orpheus016/Programmable-Instrumentation-Amplifier-IP/xschem/ota_cmos5l/README.md

# OTA Specs and Performance

## Topology


## Physical Spec
```ngspice
.param lbias=0.15u wbias=0.15u
.param m6=1 m7=4 m8=8
.param linpair=3u winpair=20u
.param lload=5u wload=10u
.param lcs=3u wcs=20u
.param Cc=2p
```

## Metrics
- P = 29.57uW
- Gain ($A_{ol}$) = 57.21 dB
- Phase Margin (PM) = 64.88 deg
- $f_3{dB}$ or fc = 4.02kHz
- UGB ft = 2.78 MHz
- PSD noise at 1mHz = $189.56 nV/\sqrt{Hz}$
- Vos = 124.4 uV - 2.3 mV (worst case at 1.5 V outside ICMR)

## Plots





## Future Plan
- Defo add more gm on the input pair
- Automated characterization and reporting to this file for better viewing
- CACE?
- Move .param to core
- Automate physical metric log and the improtant ops
