orpheus016/Programmable-Instrumentation-Amplifier-IP/xschem/instramp_cmos5l/README.md

# OTA Specs and Performance

## Topology


## Physical Spec
```ngspice
.param lbias=0.15u wbias=0.15u
.param m6=1 m7=4 m8=8
.param linpair=3u winpair=20u
.param lload=5u wload=10u
.param lcs=3u wcs=20u
.param Cc=2p
```

## Metrics
- TBA

## Plots

TBA

## Future Plan

TBA
