orpheus016/Programmable-Instrumentation-Amplifier-IP/xschem/ota_cmos5l/tb/tb_ota_cmos5l_ac/Phase.png

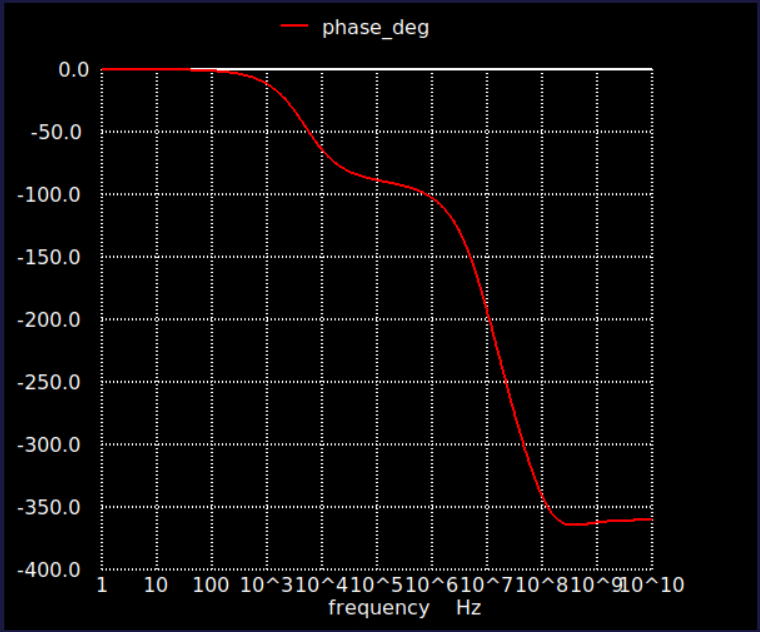
xschem/ota_cmos5l/tb/tb_ota_cmos5l_ac/Phase.png
