orpheus016/Programmable-Instrumentation-Amplifier-IP/xschem/coarse_gain/tb/tb_cg_ota/simulations/result/tb_cg_ota_mc.csv

-1.34387635e-02 -1.34387635e-02 -1.34387635e-02  7.38450235e+01
-2.05918607e-02 -2.05918607e-02 -2.05918607e-02  7.39088433e+01
-1.00258531e-02 -1.00258531e-02 -1.00258531e-02  7.38144310e+01
-1.93135983e-02 -1.93135983e-02 -1.93135983e-02  7.38974691e+01
-4.39906631e-03 -4.39906631e-03 -4.39906631e-03  7.37638051e+01
-1.29278388e-02 -1.29278388e-02 -1.29278388e-02  7.38404534e+01
-1.16658685e-02 -1.16658685e-02 -1.16658685e-02  7.38291441e+01
-1.15911407e-02 -1.15911407e-02 -1.15911407e-02  7.38284727e+01
-1.43986031e-02 -1.43986031e-02 -1.43986031e-02  7.38536136e+01
-1.26565231e-02 -1.26565231e-02 -1.26565231e-02  7.38380199e+01
-1.77818139e-02 -1.77818139e-02 -1.77818139e-02  7.38838240e+01
-7.46124374e-03 -7.46124374e-03 -7.46124374e-03  7.37913851e+01
-8.64012259e-03 -8.64012259e-03 -8.64012259e-03  7.38019851e+01
-5.71183264e-03 -5.71183264e-03 -5.71183264e-03  7.37756342e+01
-1.38807343e-02 -1.38807343e-02 -1.38807343e-02  7.38489808e+01
-7.11992922e-03 -7.11992922e-03 -7.11992922e-03  7.37883161e+01
-9.72987968e-03 -9.72987968e-03 -9.72987968e-03  7.38117768e+01
-8.88432773e-03 -8.88432773e-03 -8.88432773e-03  7.38041821e+01
-1.29114459e-02 -1.29114459e-02 -1.29114459e-02  7.38403068e+01
-1.26634110e-02 -1.26634110e-02 -1.26634110e-02  7.38380830e+01
-8.90168015e-03 -8.90168015e-03 -8.90168015e-03  7.38043364e+01
-7.39393628e-03 -7.39393628e-03 -7.39393628e-03  7.37907832e+01
-6.30688033e-03 -6.30688033e-03 -6.30688033e-03  7.37809958e+01
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
-2.00083376e-02 -2.00083376e-02 -2.00083376e-02  7.39036557e+01
-1.66586791e-02 -1.66586791e-02 -1.66586791e-02  7.38738045e+01
-1.30139339e-02 -1.30139339e-02 -1.30139339e-02  7.38412196e+01
-9.79154033e-03 -9.79154033e-03 -9.79154033e-03  7.38123270e+01
-1.49115925e-02 -1.49115925e-02 -1.49115925e-02  7.38581981e+01
-9.58710271e-03 -9.58710271e-03 -9.58710271e-03  7.38104955e+01
-1.02307613e-02 -1.02307613e-02 -1.02307613e-02  7.38162740e+01
-2.17640397e-02 -2.17640397e-02 -2.17640397e-02  7.39192677e+01
-7.36889456e-03 -7.36889456e-03 -7.36889456e-03  7.37905546e+01
-1.40237872e-02 -1.40237872e-02 -1.40237872e-02  7.38502614e+01
-1.79967887e-02 -1.79967887e-02 -1.79967887e-02  7.38857361e+01
-8.21061456e-03 -8.21061456e-03 -8.21061456e-03  7.37981236e+01
