orpheus016/Programmable-Instrumentation-Amplifier-IP/xschem/coarse_gain/tb/tb_cg_ota/simulations/result/tb_cg_ota_mc.png

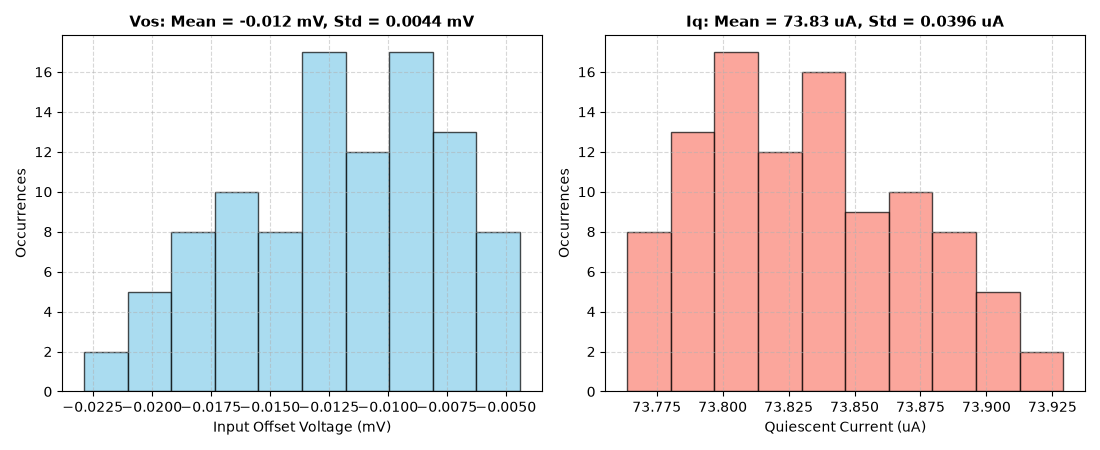
xschem/coarse_gain/tb/tb_cg_ota/simulations/result/tb_cg_ota_mc.png
