orpheus016/Programmable-Instrumentation-Amplifier-IP/xschem/coarse_gain/simulations/cg_network.spice

** sch_path: /foss/designs/sg13cmos5l_spma_ip__instramp/xschem/coarse_gain/cg_network.sch
**.subckt cg_network S4 S5 S0 S2 S1 S3 S14 S13 S12 S11 S10 S9 S8 S7 S6 S15 AVDD V_CM V_IN2 V_OUT2 I_BIAS AVSS
*.ipin I_BIAS
*.ipin V_IN2
*.ipin V_CM
*.ipin AVSS
*.ipin AVDD
*.opin V_OUT2
*.ipin S15
*.ipin S14
*.ipin S13
*.ipin S12
*.ipin S11
*.ipin S10
*.ipin S9
*.ipin S8
*.ipin S7
*.ipin S6
*.ipin S5
*.ipin S4
*.ipin S3
*.ipin S2
*.ipin S1
*.ipin S0
XR2 net12 net13 AVSS rhigh w=0.5e-6 l=9.6e-6 m=1 b=32 mm_ok=1
XR3 net13 net14 AVSS rhigh w=0.5e-6 l=4.5e-6 m=1 b=32 mm_ok=1
XR4 net14 net15 AVSS rhigh w=0.5e-6 l=5e-6 m=1 b=16 mm_ok=1
XR5 net15 net16 AVSS rhigh w=0.5e-6 l=5.5e-6 m=1 b=8 mm_ok=1
XR6 net16 net11 AVSS rhigh w=0.5e-6 l=4.7e-6 m=1 b=4 mm_ok=1
XR7 net11 net10 AVSS rhigh w=0.5e-6 l=5.41e-6 m=1 b=2 mm_ok=1
XR8 net10 net9 AVSS rhigh w=0.5e-6 l=3.34e-6 m=1 b=2 mm_ok=1
XR9 net9 net8 AVSS rhigh w=0.5e-6 l=7.39e-6 m=1 b=0 mm_ok=1
XR10 net8 net7 AVSS rhigh w=0.5e-6 l=4.76e-6 m=1 b=0 mm_ok=1
XR11 net7 net6 AVSS rhigh w=0.5e-6 l=3.06e-6 m=1 b=0 mm_ok=1
XR12 net6 net5 AVSS rhigh w=0.5e-6 l=1.94e-6 m=1 b=0 mm_ok=1
XR16 net2 net1 AVSS rppd w=2e-6 l=8.08e-6 m=1 b=0 mm_ok=1
XR17 net3 net2 AVSS rppd w=2e-6 l=5.1e-6 m=1 b=1 mm_ok=1
XR15 net1 V_OUT2 AVSS rppd w=2e-6 l=7.6e-6 m=1 b=0 mm_ok=1
XR18 net17 V_IN2 AVSS rppd w=0.5e-6 l=3.62e-6 m=1 b=0 mm_ok=1
XR1 net4 net3 AVSS rppd w=2e-6 l=8.65e-6 m=1 b=1 mm_ok=1
XR13 net5 net4 AVSS rppd w=2e-6 l=8.5e-6 m=1 b=2 mm_ok=1
x18 net18 S15 AVDD AVSS sg13cmos5l_inv_1
x19 net19 S14 AVDD AVSS sg13cmos5l_inv_1
x20 net20 S13 AVDD AVSS sg13cmos5l_inv_1
x21 net21 S12 AVDD AVSS sg13cmos5l_inv_1
x22 net22 S11 AVDD AVSS sg13cmos5l_inv_1
x23 net23 S10 AVDD AVSS sg13cmos5l_inv_1
x24 net24 S9 AVDD AVSS sg13cmos5l_inv_1
x25 net25 S8 AVDD AVSS sg13cmos5l_inv_1
x26 net26 S7 AVDD AVSS sg13cmos5l_inv_1
x27 net27 S6 AVDD AVSS sg13cmos5l_inv_1
x28 net28 S5 AVDD AVSS sg13cmos5l_inv_1
x29 net29 S4 AVDD AVSS sg13cmos5l_inv_1
x30 net30 S3 AVDD AVSS sg13cmos5l_inv_1
x31 net31 S2 AVDD AVSS sg13cmos5l_inv_1
x32 net32 S1 AVDD AVSS sg13cmos5l_inv_1
x33 net33 S0 AVDD AVSS sg13cmos5l_inv_1
x2 net17 AVSS AVDD S15 net18 net12 tgate l=0.13e-6 wn=0.15e-6 wp=0.45e-6
x3 net17 AVSS AVDD S14 net19 net13 tgate l=0.13e-6 wn=0.15e-6 wp=0.45e-6
x4 net17 AVSS AVDD S13 net20 net14 tgate l=0.13e-6 wn=0.15e-6 wp=0.45e-6
x5 net17 AVSS AVDD S12 net21 net15 tgate l=0.13e-6 wn=0.15e-6 wp=0.45e-6
x6 net17 AVSS AVDD S11 net22 net16 tgate l=0.13e-6 wn=0.15e-6 wp=0.45e-6
x7 net17 AVSS AVDD S10 net23 net11 tgate l=0.13e-6 wn=0.2e-6 wp=0.6e-6
x8 net17 AVSS AVDD S9 net24 net10 tgate l=0.13e-6 wn=0.5e-6 wp=1.5e-6
x9 net17 AVSS AVDD S8 net25 net9 tgate l=0.13e-6 wn=1e-6 wp=3e-6
x10 net17 AVSS AVDD S7 net26 net8 tgate l=0.13e-6 wn=1e-6 wp=3e-6
x11 net17 AVSS AVDD S6 net27 net7 tgate l=0.13e-6 wn=1.5e-6 wp=4.5e-6
x12 net17 AVSS AVDD S5 net28 net6 tgate l=0.13e-6 wn=2e-6 wp=6e-6
x13 net17 AVSS AVDD S4 net29 net5 tgate l=0.13e-6 wn=3e-6 wp=9e-6
x14 net17 AVSS AVDD S3 net30 net4 tgate l=0.13e-6 wn=3e-6 wp=9e-6
x15 net17 AVSS AVDD S2 net31 net3 tgate l=0.13e-6 wn=3e-6 wp=9e-6
x16 net17 AVSS AVDD S1 net32 net2 tgate l=0.13e-6 wn=3e-6 wp=9e-6
x17 net17 AVSS AVDD S0 net33 net1 tgate l=0.13e-6 wn=3e-6 wp=9e-6
x1 AVDD V_CM net17 V_OUT2 I_BIAS AVSS cg_ota
**.ends

* expanding   symbol:  /foss/designs/sg13cmos5l_spma_ip__instramp/xschem/tgate/tgate.sym # of pins=6
** sym_path: /foss/designs/sg13cmos5l_spma_ip__instramp/xschem/tgate/tgate.sym
** sch_path: /foss/designs/sg13cmos5l_spma_ip__instramp/xschem/tgate/tgate.sch
.subckt tgate IN AVSS AVDD EN ENB OUT  l=0.13e-6 wn=1e-6 wp=3e-6
*.iopin AVDD
*.iopin AVSS
*.iopin IN
*.iopin OUT
*.ipin EN
*.ipin ENB
XM1 IN EN OUT AVSS sg13_lv_nmos w=wn l=l ng=1 m=1 mm_ok=1
XM2 OUT ENB IN AVDD sg13_lv_pmos w=wp l=l ng=1 m=1 mm_ok=1
.ends


* expanding   symbol:  cg_ota.sym # of pins=6
** sym_path: /foss/designs/sg13cmos5l_spma_ip__instramp/xschem/coarse_gain/cg_ota.sym
** sch_path: /foss/designs/sg13cmos5l_spma_ip__instramp/xschem/coarse_gain/cg_ota.sch
.subckt cg_ota VDD V_inp V_inn V_out I_bias VSS
*.ipin V_inn
*.ipin VDD
*.ipin VSS
*.opin V_out
*.ipin I_bias
*.ipin V_inp
XM1 F1 V_inn net6 VDD sg13_lv_pmos w=26.56u l=2u ng=4 m=1 mm_ok=1
XM2 F2 V_inp net6 VDD sg13_lv_pmos w=26.56u l=2u ng=4 m=1 mm_ok=1
XM3 net5 net5 VDD VDD sg13_lv_pmos w=7.33u l=2u ng=1 m=1 mm_ok=1
XM4 N_A net5 VDD VDD sg13_lv_pmos w=7.33u l=2u ng=1 m=1 mm_ok=1
XM7 F1 V_bn2 VSS VSS sg13_lv_nmos w=9.21u l=2u ng=1 m=1 mm_ok=1
XM8 F2 V_bn2 VSS VSS sg13_lv_nmos w=9.21u l=2u ng=1 m=1 mm_ok=1
XM_tail net6 V_btail VDD VDD sg13_lv_pmos w=7.46u l=2u ng=1 m=8 mm_ok=1
XM_ctrlp N_B V_ctrlp N_A VDD sg13_lv_pmos w=2.20u l=0.50u ng=1 m=1 mm_ok=1
XM_outp V_out N_A VDD VDD sg13_lv_pmos w=22.20u l=0.5u ng=4 m=1 mm_ok=1
XM_ctrln N_A V_ctrln N_B VSS sg13_lv_nmos w=0.84u l=0.5u ng=1 m=1 mm_ok=1
XM_outn V_out N_B VSS VSS sg13_lv_nmos w=8.4u l=0.5u ng=1 m=1 mm_ok=1
XM5 net5 V_bn1 F1 VSS sg13_lv_nmos w=6.41u l=2u ng=1 m=1 mm_ok=1
XM6 N_A V_bn1 F2 VSS sg13_lv_nmos w=6.41u l=2u ng=1 m=1 mm_ok=1
XM_mp1 net1 net1 VDD VDD sg13_lv_pmos w=2.30u l=2u ng=1 m=1 mm_ok=1
XM_mn1 net1 I_bias VSS VSS sg13_lv_nmos w=0.87u l=2u ng=1 m=1 mm_ok=1
XM_refn I_bias I_bias VSS VSS sg13_lv_nmos w=0.87u l=2u ng=1 m=1 mm_ok=1
XM_mp2 V_bn1 net1 VDD VDD sg13_lv_pmos w=11.50u l=2u ng=2 m=1 mm_ok=1
XM_mp3 V_bn2 net1 VDD VDD sg13_lv_pmos w=23u l=2u ng=4 m=1 mm_ok=1
XM_bn1 V_bn1 V_bn1 net2 VSS sg13_lv_nmos w=1.60u l=2u ng=1 m=1 mm_ok=1
XM_bn2 V_bn2 V_bn2 VSS VSS sg13_lv_nmos w=9.21u l=2u ng=1 m=1 mm_ok=1
XM_mn2 V_btail I_bias VSS VSS sg13_lv_nmos w=6u l=2u ng=1 m=1 mm_ok=1
XM_rep_tail V_btail V_btail VDD VDD sg13_lv_pmos w=7.46u l=2u ng=1 m=8 mm_ok=1
XM_mn4 N_B I_bias VSS VSS sg13_lv_nmos w=3.2u l=2u ng=1 m=1 mm_ok=1
XC1 F2 V_out cap_cmomf w=22e-6 l=22e-6 mmin=1 mmax=4 subblock=0 m=1 mm_ok=1
XC2 net7 V_out cap_cmomf w=15.44e-6 l=15.44e-6 mmin=1 mmax=4 subblock=0 m=1 mm_ok=1
XR1 net2 VSS VSS rhigh w=0.5e-6 l=15e-6 m=1 b=0 mm_ok=1
XM_mp4 V_ctrln net1 VDD VDD sg13_lv_pmos w=4.60u l=2u ng=1 m=1 mm_ok=1
XM_rep_ctrln V_ctrln V_ctrln net3 VSS sg13_lv_nmos w=0.84u l=0.5u ng=1 m=1 mm_ok=1
XM_rep_outn net3 net3 VSS VSS sg13_lv_nmos w=2.10u l=0.5u ng=1 m=1 mm_ok=1
XM_mn3 V_ctrlp I_bias VSS VSS sg13_lv_nmos w=1.74u l=2u ng=1 m=1 mm_ok=1
XM_rep_outp net4 net4 VDD VDD sg13_lv_pmos w=5.55u l=0.5u ng=1 m=1 mm_ok=1
XM_rep_ctrlp V_ctrlp V_ctrlp net4 VDD sg13_lv_pmos w=2.20u l=0.50u ng=1 m=1 mm_ok=1
XM_mp5 N_A net1 VDD VDD sg13_lv_pmos w=9.21u l=2u ng=1 m=1 mm_ok=1
XR2 N_A net7 VSS rhigh w=0.5e-6 l=4e-6 m=1 b=0 mm_ok=1
.ends

.end
