orpheus016/Programmable-Instrumentation-Amplifier-IP/xschem/decoder_top_10b/librelane/final/spice/decoder_top_10b.spice

* NGSPICE file created from decoder_top_10b.ext - technology: ihp-sg13g2

* Black-box entry subcircuit for sg13g2_fill_1 abstract view
.subckt sg13g2_fill_1 VDD VSS
.ends

* Black-box entry subcircuit for sg13g2_decap_8 abstract view
.subckt sg13g2_decap_8 VDD VSS
.ends

* Black-box entry subcircuit for sg13g2_decap_4 abstract view
.subckt sg13g2_decap_4 VDD VSS
.ends

* Black-box entry subcircuit for sg13g2_fill_2 abstract view
.subckt sg13g2_fill_2 VDD VSS
.ends

* Black-box entry subcircuit for sg13g2_buf_1 abstract view
.subckt sg13g2_buf_1 X A VDD VSS
.ends

* Black-box entry subcircuit for sg13g2_nor3_1 abstract view
.subckt sg13g2_nor3_1 Y A B C VDD VSS
.ends

* Black-box entry subcircuit for sg13g2_nor4_1 abstract view
.subckt sg13g2_nor4_1 Y A B C D VDD VSS
.ends

* Black-box entry subcircuit for sg13g2_inv_1 abstract view
.subckt sg13g2_inv_1 Y A VDD VSS
.ends

* Black-box entry subcircuit for sg13g2_nor2_1 abstract view
.subckt sg13g2_nor2_1 Y A B VDD VSS
.ends

* Black-box entry subcircuit for sg13g2_nand3_1 abstract view
.subckt sg13g2_nand3_1 Y A B C VDD VSS
.ends

* Black-box entry subcircuit for sg13g2_nand2_1 abstract view
.subckt sg13g2_nand2_1 Y A B VDD VSS
.ends

* Black-box entry subcircuit for sg13g2_nand2b_1 abstract view
.subckt sg13g2_nand2b_1 Y A_N B VDD VSS
.ends

.subckt decoder_top_10b VGND VPWR d[0] d[1] d[2] d[3] d[4] d[5] d[6] d[7] d[8] d[9]
+ s[4] s[5] s[6] s[7] s[8] s[9] sb[4] sb[5] sb[6] sb[7] sb[8] sb[9] y[0] y[10] y[11]
+ y[12] y[13] y[14] y[15] y[1] y[2] y[3] y[4] y[5] y[6] y[7] y[8] y[9]
XFILLER_3_56 VPWR VGND sg13g2_fill_1
XFILLER_6_107 VPWR VGND sg13g2_decap_8
XFILLER_9_126 VPWR VGND sg13g2_decap_4
XFILLER_0_35 VPWR VGND sg13g2_decap_8
XFILLER_9_77 VPWR VGND sg13g2_decap_8
XFILLER_6_23 VPWR VGND sg13g2_decap_8
XFILLER_3_35 VPWR VGND sg13g2_decap_8
XFILLER_7_8 VPWR VGND sg13g2_fill_2
Xoutput31 y[2] _18_/Y VPWR VGND sg13g2_buf_1
Xoutput20 sb[7] _09_/Y VPWR VGND sg13g2_buf_1
XFILLER_9_105 VPWR VGND sg13g2_decap_8
XFILLER_0_14 VPWR VGND sg13g2_decap_8
XFILLER_9_34 VPWR VGND sg13g2_decap_8
XFILLER_6_79 VPWR VGND sg13g2_decap_8
Xoutput32 y[3] _20_/Y VPWR VGND sg13g2_buf_1
Xoutput21 sb[8] _10_/Y VPWR VGND sg13g2_buf_1
XFILLER_10_127 VPWR VGND sg13g2_decap_4
XFILLER_3_14 VPWR VGND sg13g2_decap_8
XFILLER_3_69 VPWR VGND sg13g2_decap_8
XFILLER_9_57 VPWR VGND sg13g2_fill_2
XFILLER_9_13 VPWR VGND sg13g2_decap_8
XFILLER_1_91 VPWR VGND sg13g2_decap_8
XFILLER_6_58 VPWR VGND sg13g2_decap_4
Xoutput33 y[4] _21_/Y VPWR VGND sg13g2_buf_1
Xoutput22 sb[9] _11_/Y VPWR VGND sg13g2_buf_1
Xoutput11 s[4] _34_/X VPWR VGND sg13g2_buf_1
XFILLER_10_106 VPWR VGND sg13g2_decap_8
XFILLER_0_49 VPWR VGND sg13g2_decap_4
XFILLER_2_113 VPWR VGND sg13g2_decap_8
XFILLER_1_70 VPWR VGND sg13g2_decap_8
XFILLER_6_37 VPWR VGND sg13g2_decap_8
Xoutput34 y[5] _22_/Y VPWR VGND sg13g2_buf_1
Xoutput23 y[0] _14_/Y VPWR VGND sg13g2_buf_1
Xoutput12 s[5] _35_/X VPWR VGND sg13g2_buf_1
X_29_ _29_/Y _33_/A _29_/B _29_/C VPWR VGND sg13g2_nor3_1
XFILLER_3_49 VPWR VGND sg13g2_decap_8
XFILLER_7_91 VPWR VGND sg13g2_decap_8
XFILLER_8_130 VPWR VGND sg13g2_fill_2
XFILLER_9_119 VPWR VGND sg13g2_decap_8
XFILLER_0_28 VPWR VGND sg13g2_decap_8
XFILLER_5_8 VPWR VGND sg13g2_fill_1
X_28_ _28_/Y _33_/A _29_/B _32_/C VPWR VGND sg13g2_nor3_1
XFILLER_7_70 VPWR VGND sg13g2_decap_8
Xoutput35 y[6] _23_/Y VPWR VGND sg13g2_buf_1
Xoutput24 y[10] _28_/Y VPWR VGND sg13g2_buf_1
Xoutput13 s[6] _36_/X VPWR VGND sg13g2_buf_1
XFILLER_3_28 VPWR VGND sg13g2_decap_8
XFILLER_5_123 VPWR VGND sg13g2_fill_1
XFILLER_4_93 VPWR VGND sg13g2_decap_8
XFILLER_9_27 VPWR VGND sg13g2_decap_8
XFILLER_10_92 VPWR VGND sg13g2_decap_8
X_27_ _27_/Y _33_/A _29_/B _31_/C VPWR VGND sg13g2_nor3_1
Xoutput36 y[7] _25_/Y VPWR VGND sg13g2_buf_1
Xoutput25 y[11] _29_/Y VPWR VGND sg13g2_buf_1
Xoutput14 s[7] _37_/X VPWR VGND sg13g2_buf_1
XFILLER_2_127 VPWR VGND sg13g2_decap_4
XFILLER_4_72 VPWR VGND sg13g2_decap_8
XFILLER_5_102 VPWR VGND sg13g2_decap_8
XFILLER_1_4 VPWR VGND sg13g2_decap_4
XFILLER_1_84 VPWR VGND sg13g2_decap_8
X_26_ _26_/Y _33_/A _30_/B _30_/C _26_/D VPWR VGND sg13g2_nor4_1
XFILLER_10_71 VPWR VGND sg13g2_decap_8
Xoutput37 y[8] _26_/Y VPWR VGND sg13g2_buf_1
Xoutput26 y[12] _30_/Y VPWR VGND sg13g2_buf_1
Xoutput15 s[8] _38_/X VPWR VGND sg13g2_buf_1
X_09_ _09_/Y _37_/A VPWR VGND sg13g2_inv_1
XFILLER_2_106 VPWR VGND sg13g2_decap_8
XFILLER_3_8 VPWR VGND sg13g2_fill_2
XFILLER_4_51 VPWR VGND sg13g2_decap_8
XFILLER_1_63 VPWR VGND sg13g2_decap_8
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
XFILLER_0_86 VPWR VGND sg13g2_fill_1
XFILLER_9_84 VPWR VGND sg13g2_decap_8
XFILLER_6_30 VPWR VGND sg13g2_decap_8
XFILLER_3_42 VPWR VGND sg13g2_decap_8
XFILLER_3_97 VPWR VGND sg13g2_decap_8
XFILLER_9_112 VPWR VGND sg13g2_decap_8
XFILLER_0_21 VPWR VGND sg13g2_decap_8
XFILLER_0_65 VPWR VGND sg13g2_fill_2
XFILLER_3_118 VPWR VGND sg13g2_decap_8
XFILLER_9_63 VPWR VGND sg13g2_decap_8
XFILLER_6_86 VPWR VGND sg13g2_decap_8
XFILLER_9_8 VPWR VGND sg13g2_fill_2
XFILLER_3_21 VPWR VGND sg13g2_decap_8
XFILLER_3_76 VPWR VGND sg13g2_decap_8
XFILLER_9_20 VPWR VGND sg13g2_decap_8
XFILLER_10_113 VPWR VGND sg13g2_decap_8
XFILLER_2_120 VPWR VGND sg13g2_decap_8
XFILLER_2_131 VPWR VGND sg13g2_fill_1
XFILLER_9_98 VPWR VGND sg13g2_decap_8
XFILLER_6_44 VPWR VGND sg13g2_decap_8
Xoutput30 y[1] _16_/Y VPWR VGND sg13g2_buf_1
.ends
