orpheus016/Programmable-Instrumentation-Amplifier-IP/xschem/decoder_top_10b/librelane/final/nl/decoder_top_10b.nl.v

module decoder_top_10b (d,
    s,
    sb,
    y);
 input [9:0] d;
 output [9:4] s;
 output [9:4] sb;
 output [15:0] y;

 wire _00_;
 wire _01_;
 wire _02_;
 wire _03_;
 wire _04_;
 wire _05_;
 wire net1;
 wire net2;
 wire net3;
 wire net4;
 wire net5;
 wire net6;
 wire net7;
 wire net8;
 wire net9;
 wire net10;
 wire net11;
 wire net12;
 wire net13;
 wire net14;
 wire net15;
 wire net16;
 wire net17;
 wire net18;
 wire net19;
 wire net20;
 wire net21;
 wire net22;
 wire net23;
 wire net24;
 wire net25;
 wire net26;
 wire net27;
 wire net28;
 wire net29;
 wire net30;
 wire net31;
 wire net32;
 wire net33;
 wire net34;
 wire net35;
 wire net36;
 wire net37;
 wire net38;
 wire net39;
 wire net40;

 sg13g2_decap_8 FILLER_0_0 ();
 sg13g2_decap_8 FILLER_0_106 ();
 sg13g2_decap_8 FILLER_0_113 ();
 sg13g2_decap_8 FILLER_0_120 ();
 sg13g2_decap_4 FILLER_0_127 ();
 sg13g2_fill_1 FILLER_0_131 ();
 sg13g2_decap_8 FILLER_0_14 ();
 sg13g2_decap_8 FILLER_0_21 ();
 sg13g2_decap_8 FILLER_0_28 ();
 sg13g2_decap_8 FILLER_0_35 ();
 sg13g2_decap_8 FILLER_0_42 ();
 sg13g2_decap_4 FILLER_0_49 ();
 sg13g2_decap_4 FILLER_0_61 ();
 sg13g2_fill_2 FILLER_0_65 ();
 sg13g2_decap_8 FILLER_0_7 ();
 sg13g2_decap_8 FILLER_0_75 ();
 sg13g2_decap_4 FILLER_0_82 ();
 sg13g2_fill_1 FILLER_0_86 ();
 sg13g2_decap_8 FILLER_10_0 ();
 sg13g2_decap_8 FILLER_10_106 ();
 sg13g2_decap_8 FILLER_10_113 ();
 sg13g2_decap_8 FILLER_10_120 ();
 sg13g2_decap_4 FILLER_10_127 ();
 sg13g2_fill_1 FILLER_10_131 ();
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
    .X(y[4]));
 sg13g2_buf_1 output34 (.A(net34),
    .X(y[5]));
 sg13g2_buf_1 output35 (.A(net35),
    .X(y[6]));
 sg13g2_buf_1 output36 (.A(net36),
    .X(y[7]));
 sg13g2_buf_1 output37 (.A(net37),
    .X(y[8]));
 sg13g2_buf_1 output38 (.A(net38),
    .X(y[9]));
endmodule
