orpheus016/Programmable-Instrumentation-Amplifier-IP/(commit log)

2026-08-14 add inv designs
    [inv.sch, inv_tb.sch, untitled.sch]
2026-08-17 add: initial schematic and simulation files for CMOS inverter design
    [inv.sch, inv_tb.sch, untitled.sch]
2026-08-19 add: initial schematic and simulation files for CMOS inverter design (1)
    [inv.sch, inv_tb.sch]
2026-08-24 feat: add output buffer schematic and testbench, as well its documentations; restructure repo directories
2026-08-26 feat: add transmission gate (tgate) design, documentation, and simulation testbenches for digital gain stages
2026-08-29 feat: implement 2-to-4 line decoder using IHP 130nm standard cells with schematics and testbench
2026-08-31 feat(digital): implement and verify 4-to-16 binary decoder (dec4to16)
    - Implement 2-level pre-decoding architecture using 2x dec2to4 and 16x AND2 standard cells
    - Create schematic, symbol, and transient testbench (tb_dec4to16)
    - Verify 16-state truth table, full 1.2V rail-to-rail swing, and one-hot selection
    - Add technical documentation and transient waveforms in docs/digital_decoder/dec4to16
2026-09-01 feat: add fine_driver_6b digital decoder block, including schematic, symbol, testbench, and documentation.
2026-09-02 feat: implement 10-bit digital decoder design with supporting schematics, symbols, and simulation testbenches
2026-09-02 Initial commit for coarse-gain stage network and some analog tools
2026-09-04 Initial commit for coarse-gain stage (No simulations yet) + additional tools for designing
2026-09-04 fix: second stage linear
2026-09-05 Add README for Coarse-Gain stage documentation
    Added detailed documentation for the Coarse-Gain stage, including overview, topology, pin descriptions, specifications, and simulation.
2026-09-05 Add Coarse-Gain Stage link to README
2026-09-05 Enhance README with schematics and simulations
    Added schematics and simulations section with images.
2026-10-01 Enhance README with coarse-gain network details
    Expanded the README with details on the coarse-gain network stage, including resistor configurations and internal biasing assumptions.
2026-10-01 Manage directories of this repository, especially for coarse-gain designs
    [cg_network.sch, cg_ota.sch, tb_cg_network.sch, tb_cg_ota.sch]
2026-10-01 Repository management for digital core blocks
    [dec2to4.sch, dec4to16.sch, decoder_top_10b.sch, decoder_top_10b__nom_fast_1p32V_m40C.sdf, decoder_top_10b__nom_slow_1p08V_125C.sdf, decoder_top_10b__nom_typ_1p20V_25C.sdf, fine_driver_6b.sch, metrics.csv]
2026-10-01 Prepare tb_cg_ota simulations again
    [instramp_cmos5l.sch, ota_cmos5l.sch, tb_cg_network.sch, tb_cg_ota.sch, tb_instramp_cmos5l_ac.sch, tb_instramp_cmos5l_dc.sch, tb_ota_cmos5l_ac.sch, tb_ota_cmos5l_dc.sch]
2026-10-02 Add component sizing summary for coarse-gain network
    Added detailed component sizing information for the coarse-gain network, including main core transistors, Miller compensation capacitors, and bias generator circuitry.
2026-10-02 Revise README for coarse-gain stage details
    Updated README to enhance clarity and detail of the coarse-gain stage implementation, including architecture, specifications, and performance summaries.
2026-10-02 First commit for coarse-gain network simulation, but needs a further tuning
    [cg_network.sch, tb_cg_ota.sch]
2026-10-02 Fine gain testbench initial commit
    [fine_gain.sch]
2026-10-02 repo restructuring
    [tb_fine_gain.sch, tg.sch, untitled.sch]
2026-10-03 Finalize coarse-gain simulations
    [cg_ota.sch, tb_cg_ota.sch]
2026-10-03 Add simulation result files to repo so that it is easier to load them
    [tb_cg_ota_mc.csv]
2026-10-03 Repo restructuring to remove ./designs
    [inv.sch, inv_tb.sch, ota_5t.sch, output_buffer.sch, output_buffer_tb.sch]
2026-10-03 Document coarse-gain stage component sizing details
    Added detailed component sizing information for coarse-gain stage, including feedback resistor string and transmission gate switches.
2026-10-03 Update headings for feedback resistor and switches
2026-10-03 Finalized coarse-gain stage simulation documentation
